naoto64/2bit-CPU/README.md

# 2bit-CPU
2bit CPU using 74HC series logic IC.

## Overview
This is a 2bit CPU KiCad file. You can make a CPU using the 74HC series logic IC.

## Circuit Diagram
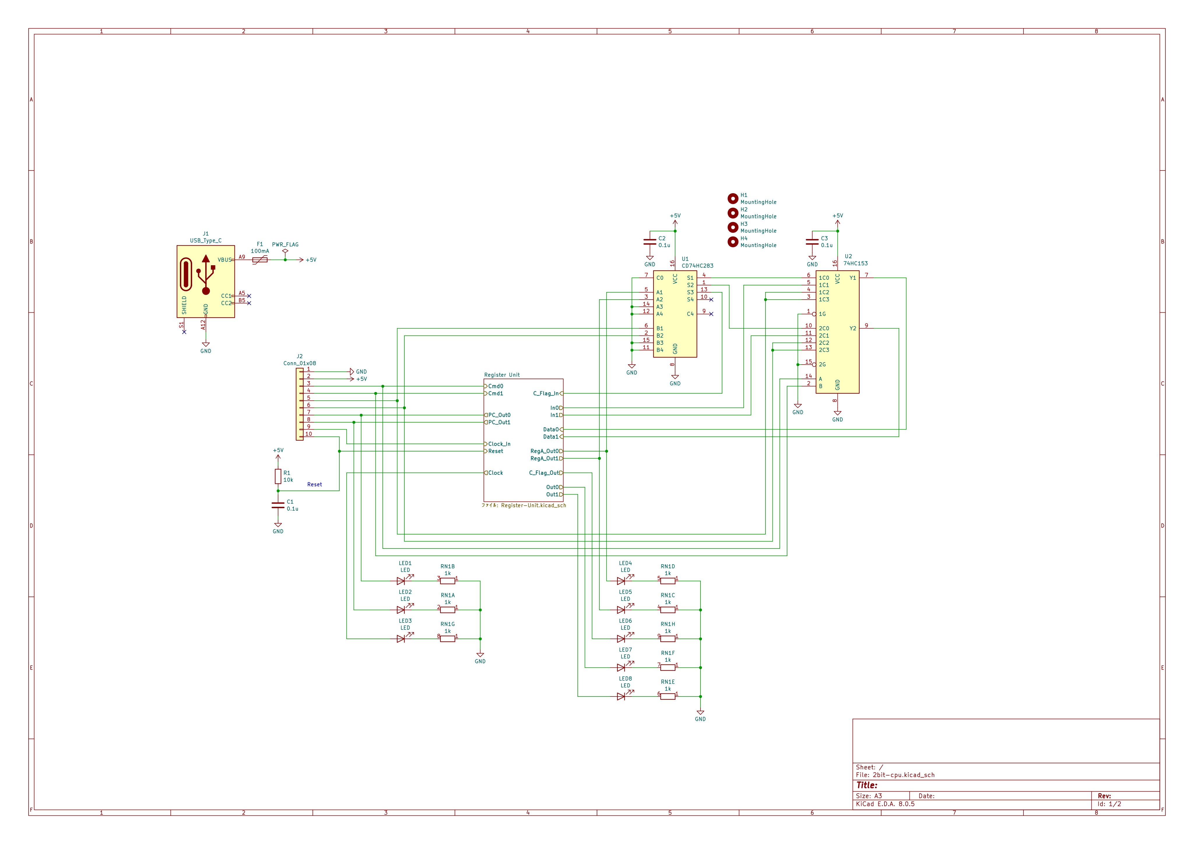
[picture p1: docs/img/schematic01.jpg]

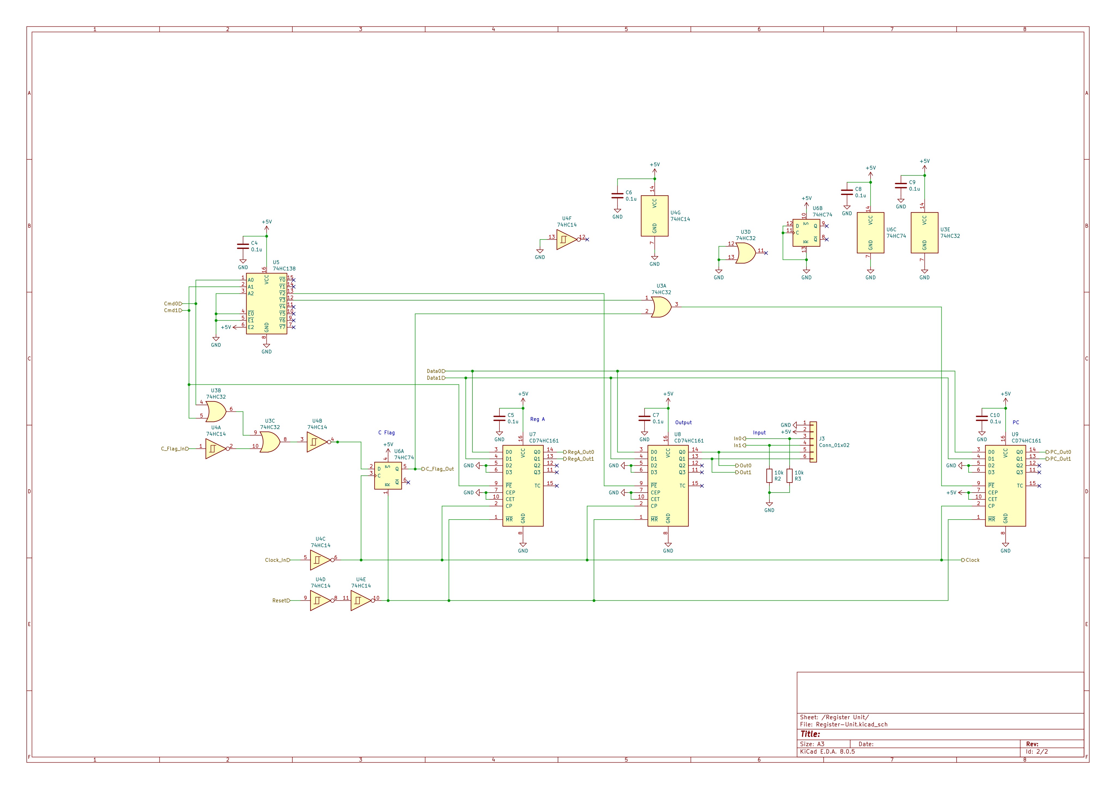
[picture p2: docs/img/schematic02.jpg]

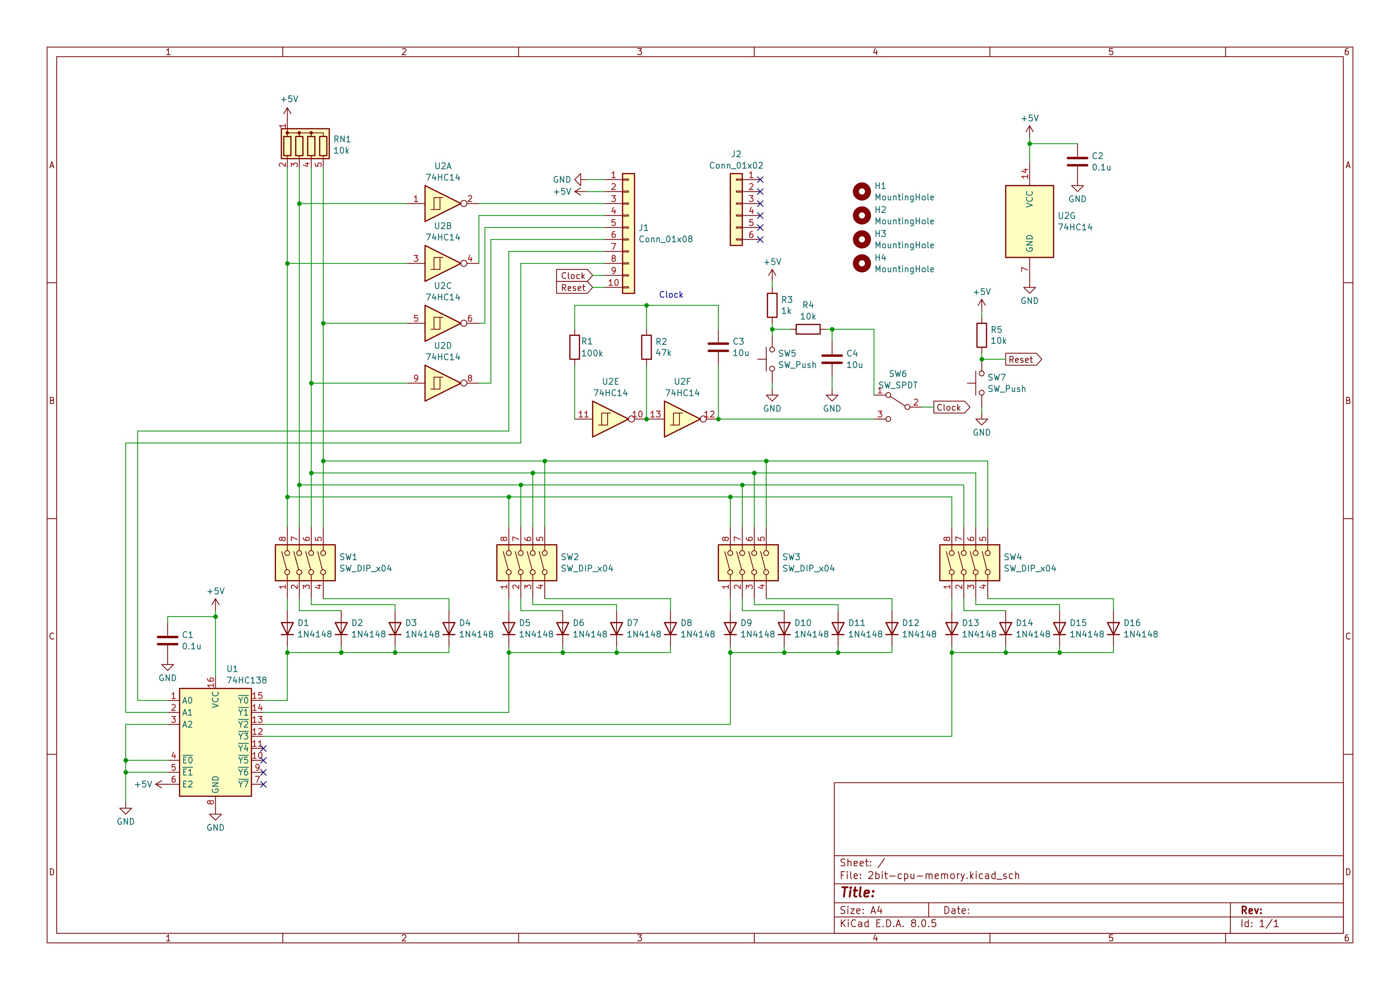
[picture p3: docs/img/schematic03.jpg]
