naoto64/2bit-CPU/2bit-cpu/2bit-cpu.kicad_pcb

## KiCad design 2bit-cpu/2bit-cpu.kicad_pcb (2024-09-17)

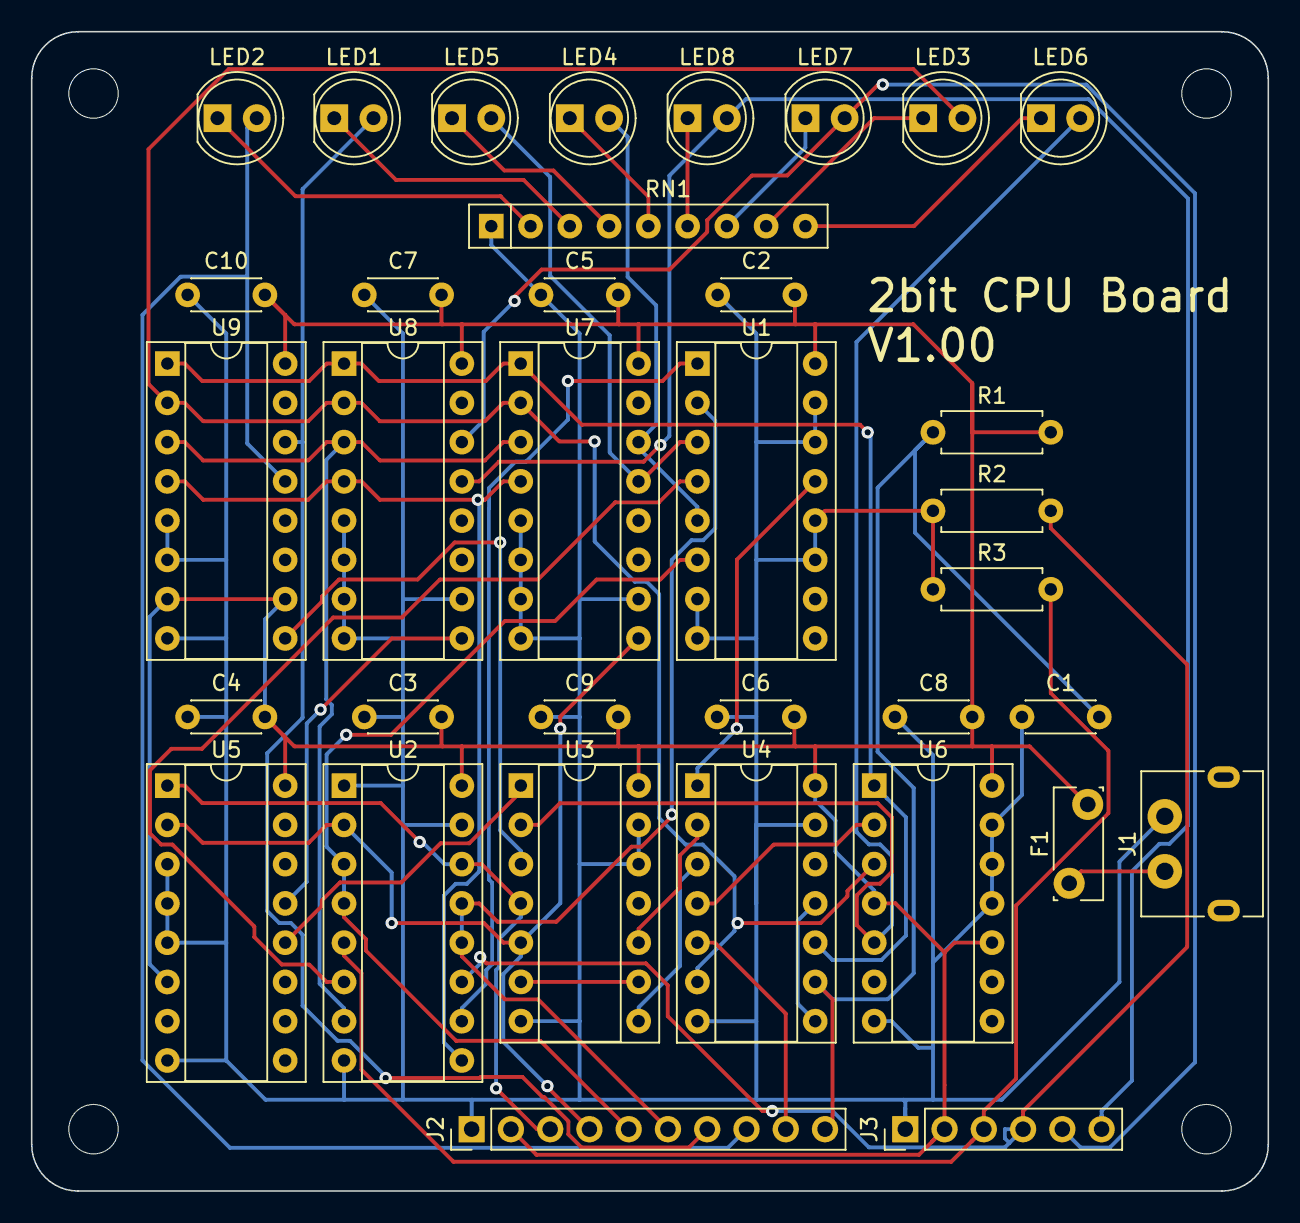
[picture p8: board 2bit-cpu.kicad_pcb from above]

Board: 2 copper layers, 80.0 x 75.0 mm, 39 parts (0 on the bottom side), 41 nets.

Parts:
C1, C2, C3, C4, C5, C6, C7, C8, C9, C10: 0.1u; C_Disc_D4.3mm_W1.9mm_P5.00mm
F1: 100mA; Fuse_Bourns_MF-RG300
H1, H2, H3, H4: MountingHole; MountingHole_3.2mm_M3
J1: USB_Type_C; USB_C_PowerOnly
J2: Conn_01x08; PinHeader_1x10_P2.54mm_Vertical
J3: Conn_01x02; PinHeader_1x06_P2.54mm_Vertical
LED1, LED2, LED3, LED4, LED5, LED6, LED7, LED8: LED; LED_D5.0mm
R1, R2, R3: 10k; R_Axial_DIN0207_L6.3mm_D2.5mm_P7.62mm_Horizontal
RN1: 1k; R_Array_SIP9
U1: CD74HC283; DIP-16_W7.62mm_Socket
U2: 74HC153; DIP-16_W7.62mm_Socket
U3: 74HC32; DIP-14_W7.62mm_Socket
U4: 74HC14; DIP-14_W7.62mm_Socket
U5: 74HC138; DIP-16_W7.62mm_Socket
U6: 74HC74; DIP-14_W7.62mm_Socket
U7, U8, U9: CD74HC161; DIP-16_W7.62mm_Socket

Connections:
+5V: C2.2, C3.2, C4.2, C5.2, C6.2, C7.2, C8.2, C9.2, C10.2, F1.2, J2.2, J3.2, R1.2, U1.16 (VCC), U2.16 (VCC), U3.14 (VCC), U4.14 (VCC), U5.6 (E2), U5.16 (VCC), U6.4 (~S), U6.10 (~S), U6.14 (VCC), U7.16 (VCC), U8.16 (VCC), U9.7 (CEP), U9.10 (CET), U9.16 (VCC)
/Register Unit/C_Flag_In: U1.13 (S3), U4.1
/Register Unit/C_Flag_Out: LED6.2 (A), U3.2, U6.5 (Q)
/Register Unit/Clock: LED3.2 (A), U4.6, U6.3 (C), U7.2 (CP), U8.2 (CP), U9.2 (CP)
/Register Unit/Clock_In: J2.9, U4.5
/Register Unit/Cmd0: J2.3, U2.14 (A), U3.4, U5.1 (A0)
/Register Unit/Cmd1: J2.4, U2.2 (B), U3.5, U5.2 (A1), U7.9 (~PE)
/Register Unit/Data0: U2.7 (Y1), U7.3 (D0), U8.3 (D0), U9.3 (D0)
/Register Unit/Data1: U2.9 (Y2), U7.4 (D1), U8.4 (D1), U9.4 (D1)
/Register Unit/In0: J3.3, R3.2, U2.5 (1C1)
/Register Unit/In1: J3.4, R2.2, U2.11 (2C1)
/Register Unit/Out0: J3.5, LED7.2 (A), U8.14 (Q0)
/Register Unit/Out1: J3.6, LED8.2 (A), U8.13 (Q1)
/Register Unit/PC_Out0: J2.7, LED1.2 (A), U9.14 (Q0)
/Register Unit/PC_Out1: J2.8, LED2.2 (A), U9.13 (Q1)
/Register Unit/RegA_Out0: LED4.2 (A), U1.5 (A1), U7.14 (Q0)
/Register Unit/RegA_Out1: LED5.2 (A), U1.3 (A2), U7.13 (Q1)
/Register Unit/Reset: C1.2, J2.10, R1.1, U4.9
GND: C1.1, C2.1, C3.1, C4.1, C5.1, C6.1, C7.1, C8.1, C9.1, C10.1, J1.A12 (GND), J2.1, J3.1, R2.1, R3.1, RN1.1 (R1), U1.7 (C0), U1.8 (GND), U1.11 (B4), U1.12 (A4), U1.14 (A3), U1.15 (B3), U2.1 (1G), U2.8 (GND), U2.15 (2G), U3.7 (GND), U3.12, U3.13, U4.7 (GND), U4.13, U5.3 (A2), U5.4 (~E0), U5.5 (~E1), U5.8 (GND), U6.7 (GND), U6.11 (C), U6.12 (D), U6.13 (~R), U7.5 (D2), U7.6 (D3), U7.7 (CEP), U7.8 (GND), U7.10 (CET), U8.5 (D2), U8.6 (D3), U8.7 (CEP), U8.8 (GND), U8.10 (CET), U9.5 (D2), U9.6 (D3), U9.8 (GND)
unnamed: F1.1, J1.A9 (VBUS)
unnamed: J2.5, U1.6 (B1), U2.3 (1C3), U2.4 (1C2)
unnamed: J2.6, U1.2 (B2), U2.12 (2C2), U2.13 (2C3)
unnamed: LED1.1 (K), RN1.3 (R2.2)
unnamed: LED2.1 (K), RN1.2 (R1.2)
unnamed: LED3.1 (K), RN1.8 (R7.2)
unnamed: LED4.1 (K), RN1.5 (R4.2)
unnamed: LED5.1 (K), RN1.4 (R3.2)
unnamed: LED6.1 (K), RN1.9 (R8.2)
unnamed: LED7.1 (K), RN1.7 (R6.2)
unnamed: LED8.1 (K), RN1.6 (R5.2)
unnamed: U1.4 (S1), U2.6 (1C0)
unnamed: U1.1 (S2), U2.10 (2C0)
unnamed: U3.6, U3.9
unnamed: U3.8, U4.3
unnamed: U3.10, U4.2
unnamed: U4.8, U4.11
unnamed: U5.13 (~Y2), U8.9 (~PE)
unnamed: U3.1, U5.12 (~Y3)
unnamed: U4.4, U6.2 (D)
unnamed: U4.10, U6.1 (~R), U7.1 (~MR), U8.1 (~MR), U9.1 (~MR)
unnamed: U3.3, U9.9 (~PE)
