naoto64/2bit-CPU/2bit-cpu/2bit-cpu-memory/2bit-cpu-memory.kicad_pcb

## KiCad design 2bit-cpu/2bit-cpu-memory/2bit-cpu-memory.kicad_pcb (2024-09-09)

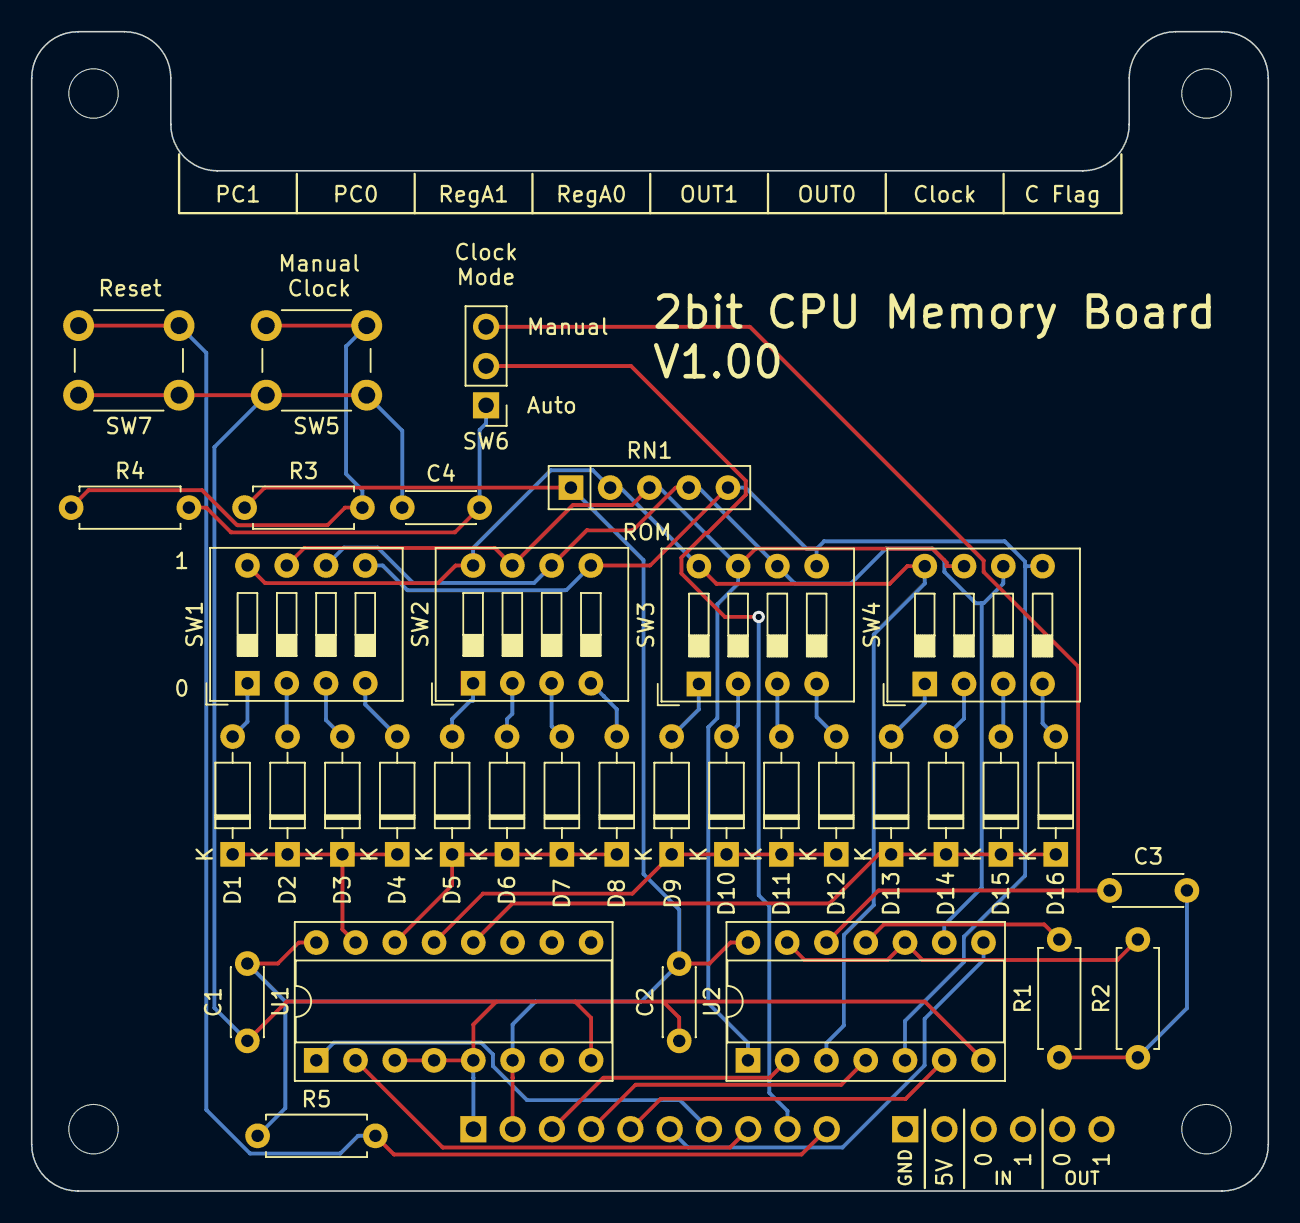
[picture p9: board 2bit-cpu-memory.kicad_pcb from above]

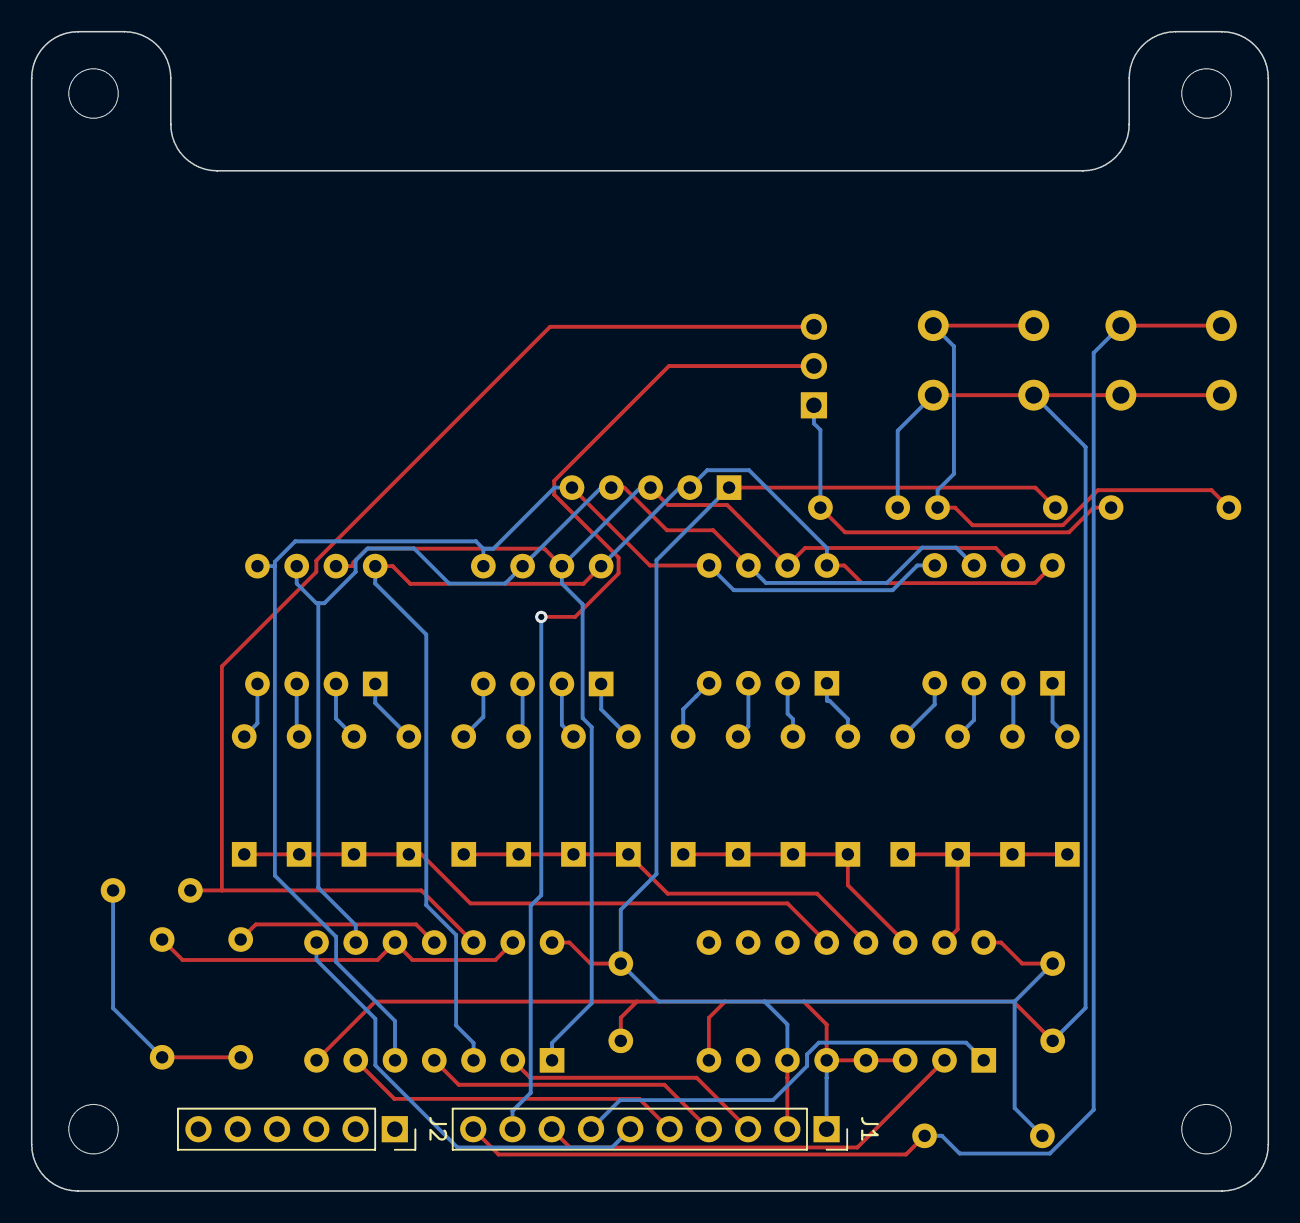
[picture p10: board 2bit-cpu-memory.kicad_pcb from below]

Board: 2 copper layers, 80.0 x 75.0 mm, 41 parts (2 on the bottom side), 40 nets.

Parts:
C1, C2: 0.1u; C_Disc_D4.3mm_W1.9mm_P5.00mm
C3, C4: 10u; C_Disc_D4.3mm_W1.9mm_P5.00mm
D1, D2, D3, D4, D5, D6, D7, D8, D9, D10, D11, D12, D13, D14, D15, D16: 1N4148; D_DO-35_SOD27_P7.62mm_Horizontal
H1, H2, H3, H4: MountingHole; MountingHole_3.2mm_M3
J1: Conn_01x08; PinSocket_1x10_P2.54mm_Vertical
J2: Conn_01x02; PinSocket_1x06_P2.54mm_Vertical
R1: 100k; R_Axial_DIN0207_L6.3mm_D2.5mm_P7.62mm_Horizontal
R2: 47k; R_Axial_DIN0207_L6.3mm_D2.5mm_P7.62mm_Horizontal
R3: 1k; R_Axial_DIN0207_L6.3mm_D2.5mm_P7.62mm_Horizontal
R4, R5: 10k; R_Axial_DIN0207_L6.3mm_D2.5mm_P7.62mm_Horizontal
RN1: 10k; R_Array_SIP5
SW1, SW2, SW3, SW4: SW_DIP_x04; SW_DIP_SPSTx04_Slide_9.78x12.34mm_W7.62mm_P2.54mm
SW5, SW7: SW_Push; SW_PUSH_6mm
SW6: SW_SPDT; PinHeader_1x03_P2.54mm_Vertical
U1: 74HC138; DIP-16_W7.62mm_Socket
U2: 74HC14; DIP-14_W7.62mm_Socket

Connections:
+5V: C1.2, C2.2, J1.2, R3.1, R5.1, RN1.1 (common), U1.6 (E2), U1.16 (VCC), U2.14 (VCC)
Clock: J1.9, SW6.2 (B)
GND: C1.1, C2.1, C4.1, J1.1, SW5.1, SW7.1, U1.3 (A2), U1.4 (~E0), U1.5 (~E1), U1.8 (GND), U2.7 (GND)
unnamed: C3.2, R1.1, R2.1
unnamed: D1.2 (A), SW1.1
unnamed: D1.1 (K), D2.1 (K), D3.1 (K), D4.1 (K), U1.15 (~Y0)
unnamed: D2.2 (A), SW1.2
unnamed: D3.2 (A), SW1.3
unnamed: D4.2 (A), SW1.4
unnamed: D5.2 (A), SW2.1
unnamed: D5.1 (K), D6.1 (K), D7.1 (K), D8.1 (K), U1.14 (~Y1)
unnamed: D6.2 (A), SW2.2
unnamed: D7.2 (A), SW2.3
unnamed: D8.2 (A), SW2.4
unnamed: D9.2 (A), SW3.1
unnamed: D10.2 (A), SW3.2
unnamed: D9.1 (K), D10.1 (K), D11.1 (K), D12.1 (K), U1.13 (~Y2)
unnamed: D11.2 (A), SW3.3
unnamed: D12.2 (A), SW3.4
unnamed: D13.2 (A), SW4.1
unnamed: D13.1 (K), D14.1 (K), D15.1 (K), D16.1 (K), U1.12 (~Y3)
unnamed: D14.2 (A), SW4.2
unnamed: D15.2 (A), SW4.3
unnamed: D16.2 (A), SW4.4
unnamed: J1.3, U2.2
unnamed: J1.4, U2.4
unnamed: J1.5, U2.6
unnamed: J1.6, U2.8
unnamed: J1.7, U1.1 (A0)
unnamed: J1.8, U1.2 (A1)
unnamed: R1.2, U2.11
unnamed: R2.2, U2.10, U2.13
unnamed: R3.2, R4.1, SW5.2
unnamed: RN1.2 (R1), SW1.8, SW2.8, SW3.8, SW4.8, U2.3
unnamed: RN1.3 (R2), SW1.7, SW2.7, SW3.7, SW4.7, U2.1
unnamed: RN1.4 (R3), SW1.6, SW2.6, SW3.6, SW4.6, U2.9
unnamed: RN1.5 (R4), SW1.5, SW2.5, SW3.5, SW4.5, U2.5
unnamed: C4.2, R4.2, SW6.1 (A)
unnamed: C3.1, SW6.3 (C), U2.12
Reset: J1.10, R5.2, SW7.2
