naoto64/2bit-CPU/docs/manual_8202_20240919.pdf

SKU: 9955

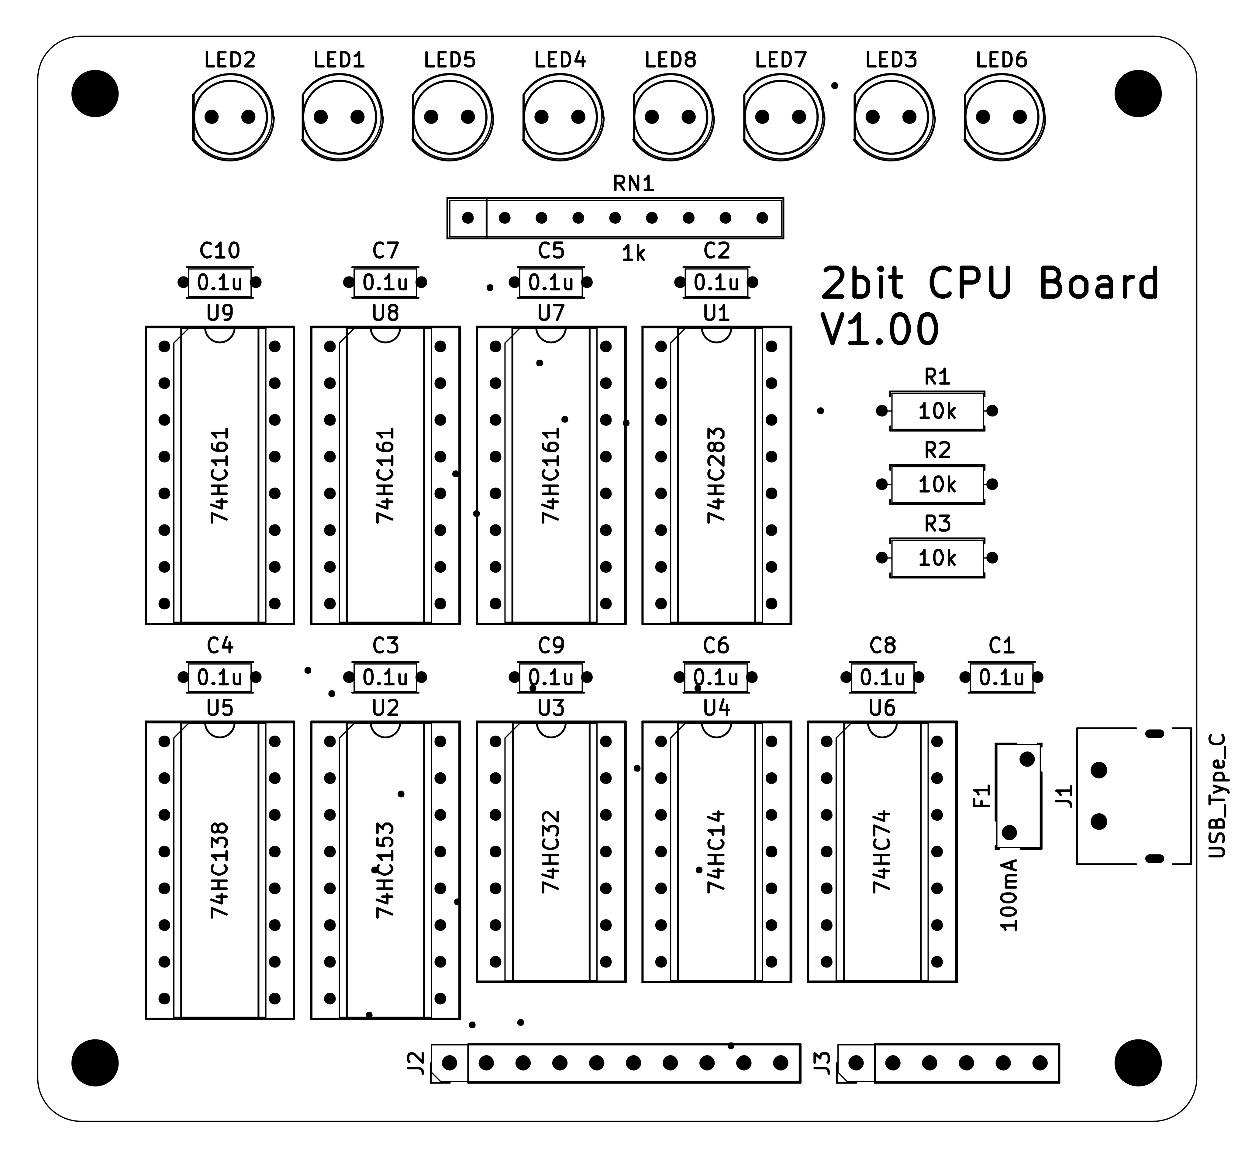
[picture p11: figure]

販売ページ: https://www.switch-science.com/products/9955

# 2bit CPU 組み立てキット

## ○実装図

以下の実装図を参考に実装して下さい。

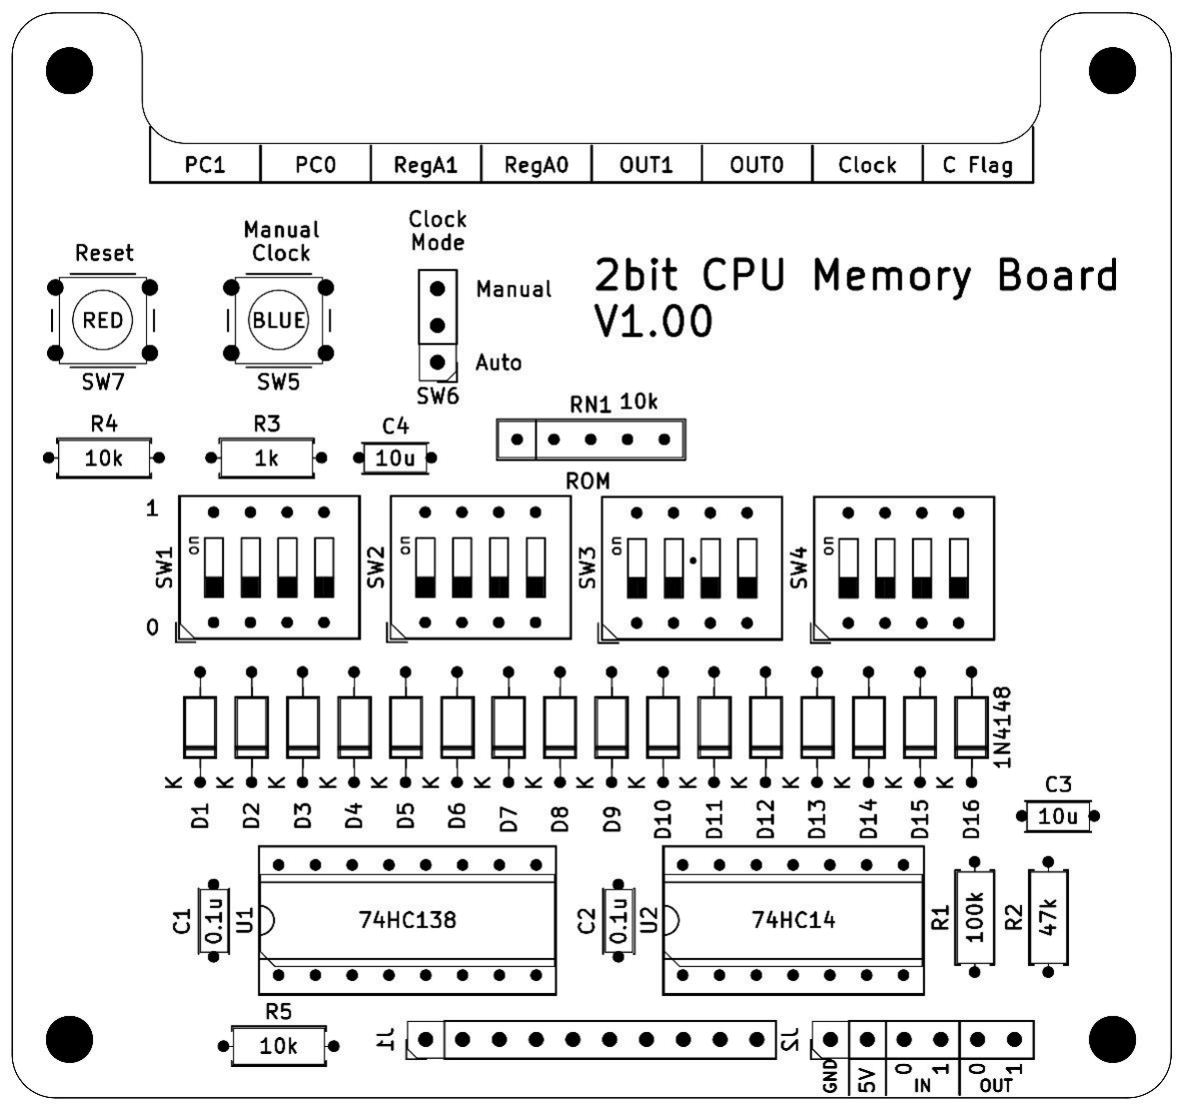
[picture p12: figure]

販売ページ: https://www.switch-science.com/products/9955

※J1・J2 は裏面に実装してください。

## ○製作例

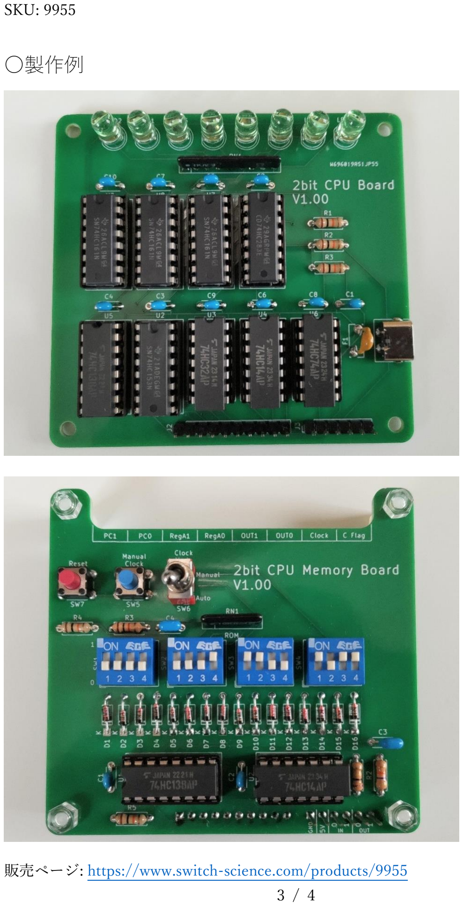
[picture p13: page 3]

販売ページ: https://www.switch-science.com/products/9955

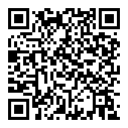
[picture p14: figure]

販売ページ: https://www.switch-science.com/products/9955

## ○注意事項

・LED は熱に弱いですので基板から離して実装して下さい。また、長時間半田ごての熱 が加わらないようご注意下さい。
・LED や IC は静電気に弱いですので取扱にはご注意下さい。 ・基板裏に金属物が接触するとショートのおそれがありますので、金属物に接触しない ようご注意下さい。
・基板のレジスト色や使用部品など製品仕様が予告なく変更になる場合がございます。 予めご了承下さい。

## ○サポートページ

詳しい説明は以下のサイトをご覧下さい。

https://naoto64.github.io/2bit-CPU/
